elanto-dev/NewDevicesLab/README.md

This project was created as a part of the course New Devices Lab.
 
https://github.com/Naveen512/IonicAndVueJWTAuthentication was used as a template for the autentication of the front-end
