elanto-dev/NewDevicesLab/3D models/BIGBDFW_SmallerAndNormal-shelf-sensors.curaproject.3mf

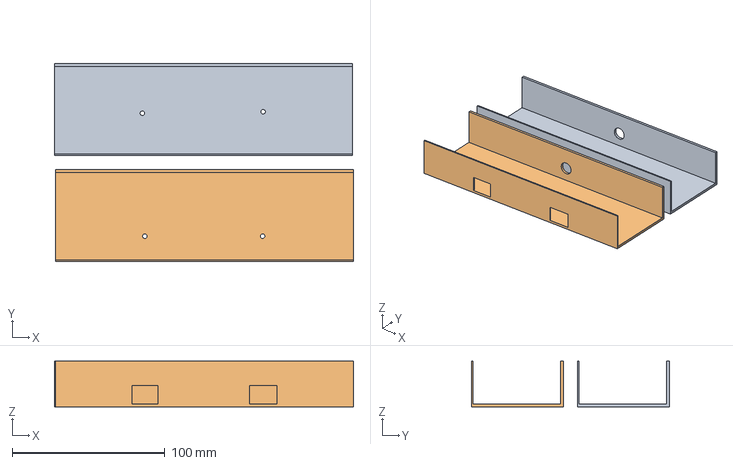
[picture p18: CAD file, 2022-10-01]
3D models/BIGBDFW_SmallerAndNormal-shelf-sensors.curaproject.3mf
195.6 x 129.4 x 30.0 mm
