elanto-dev/NewDevicesLab/3D models/Smaller-shelf-sensors.stl

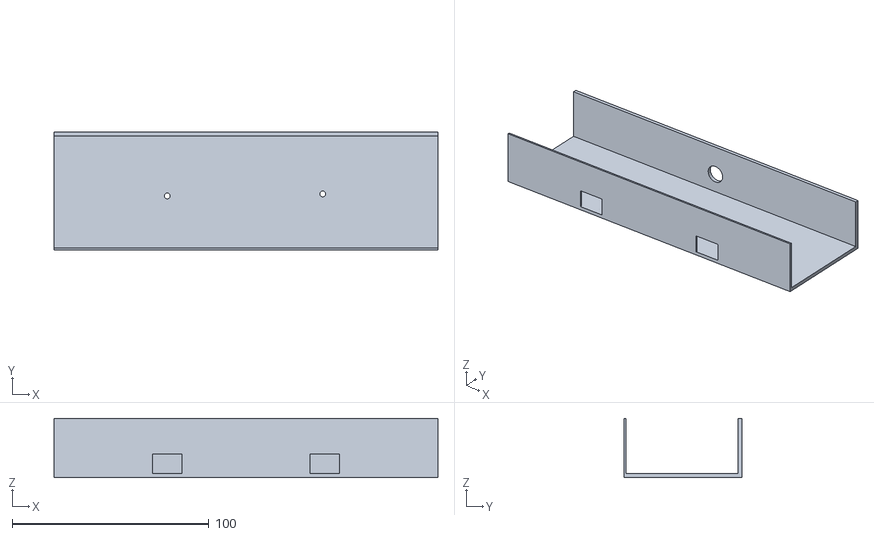
[picture p19: CAD file, 2022-10-01]
3D models/Smaller-shelf-sensors.stl
195.0 x 60.0 x 30.0
