elanto-dev/NewDevicesLab/3D models/Speaker_holder.stl

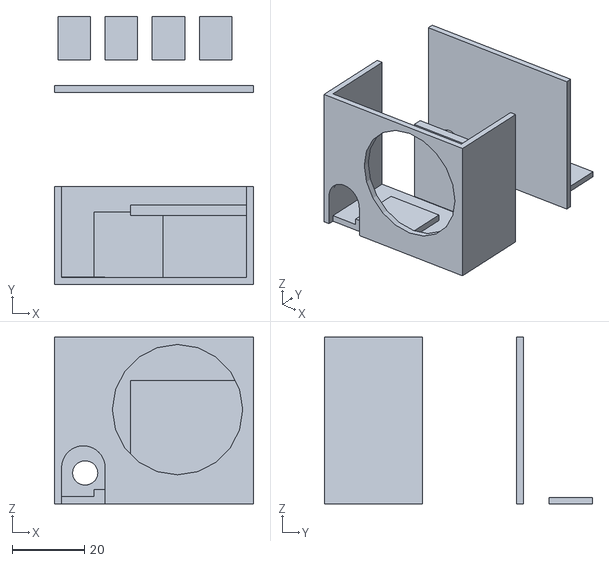
[picture p20: CAD file, 2022-10-01]
3D models/Speaker_holder.stl
55.0 x 74.0 x 46.0
