elanto-dev/NewDevicesLab/3D models/Shelf_screen_holders.curaproject.3mf

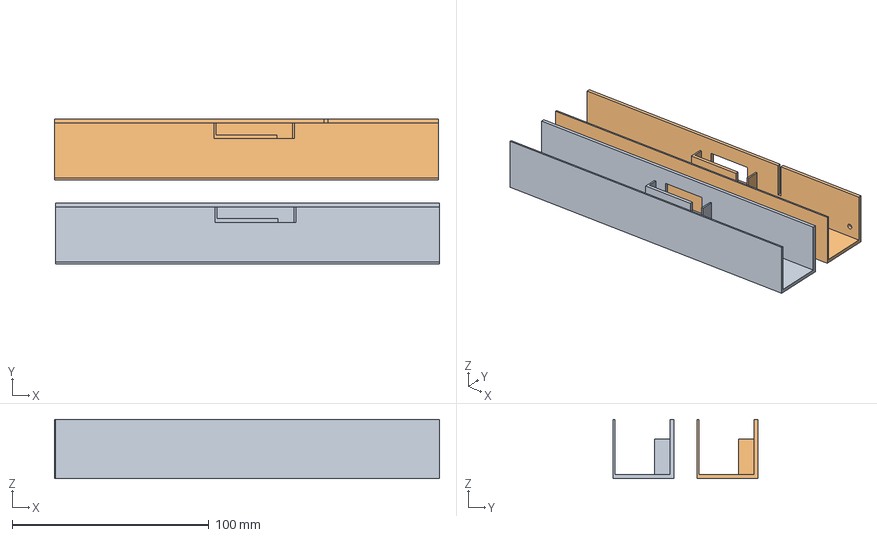
[picture p21: CAD file, 2022-10-01]
3D models/Shelf_screen_holders.curaproject.3mf
195.6 x 73.6 x 30.0 mm
