elanto-dev/NewDevicesLab/3D models/Hook.stl

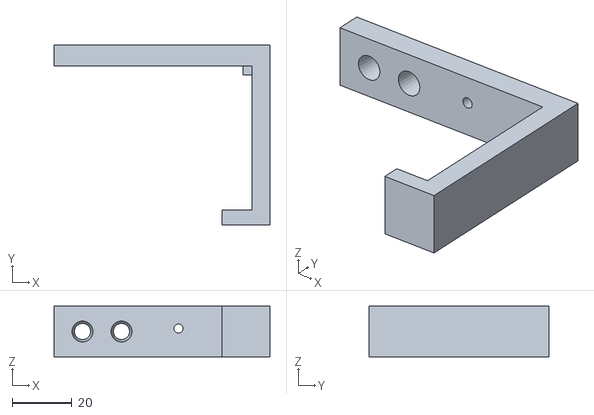
[picture p22: CAD file, 2022-10-01]
3D models/Hook.stl
72.0 x 60.0 x 17.0
