elanto-dev/NewDevicesLab/3D models/Shelf_screen_holder.stl

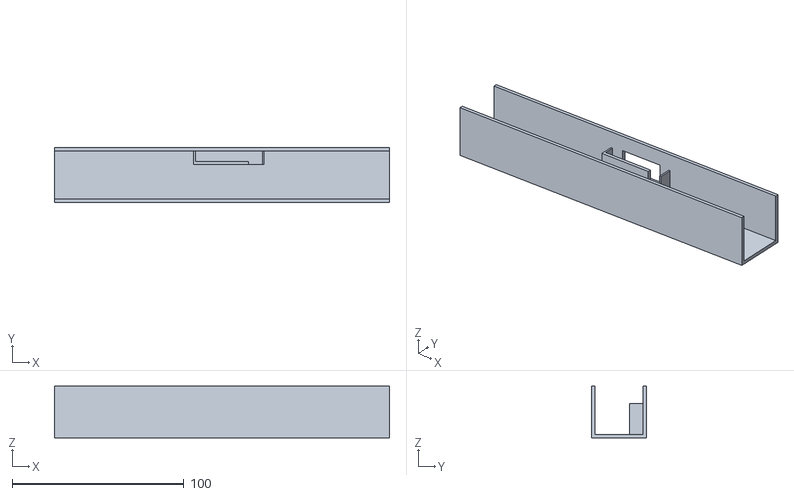
[picture p23: CAD file, 2022-10-01]
3D models/Shelf_screen_holder.stl
195.0 x 32.0 x 30.0
