elanto-dev/NewDevicesLab/3D models/Shelf_screen_holder_wNFC.stl

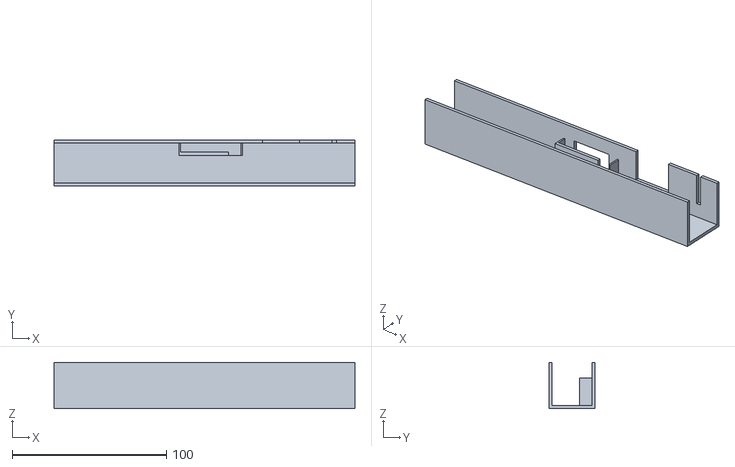
[picture p24: CAD file, 2022-10-01]
3D models/Shelf_screen_holder_wNFC.stl
195.0 x 30.0 x 30.0
