elanto-dev/NewDevicesLab/3D models/Screen_holder.curaproject.3mf

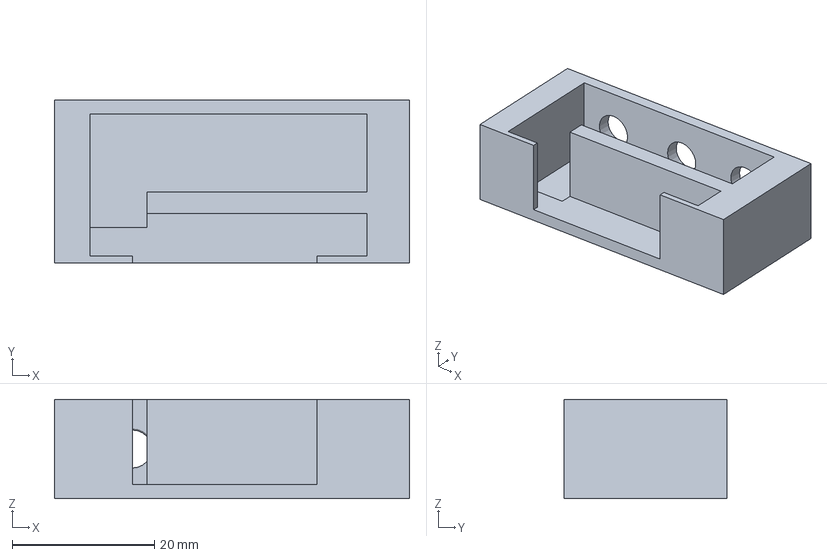
[picture p25: CAD file, 2022-10-01]
3D models/Screen_holder.curaproject.3mf
50.0 x 23.0 x 14.0 mm
