elanto-dev/NewDevicesLab/3D models/Shelf_screen_holders(1NFC-2Holders).3mf

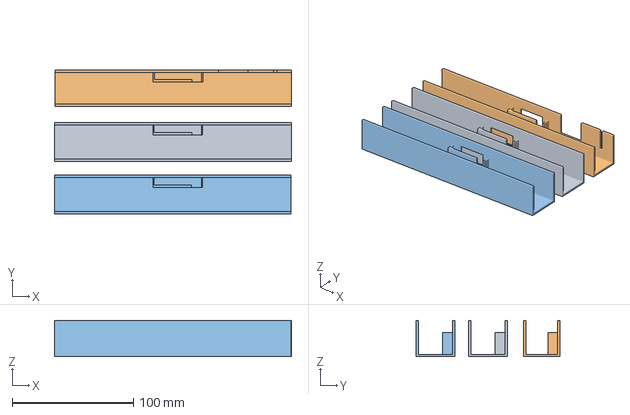
[picture p26: CAD file, 2022-10-01]
3D models/Shelf_screen_holders(1NFC-2Holders).3mf
195.3 x 118.7 x 30.0 mm
