elanto-dev/NewDevicesLab/(list of files, cad)

Other CAD files:
3D models/Shelf-sensors.stl
3D models/BIGBDFW_Shelf-sensors.curaproject.3mf
3D models/Screen_holder.stl
3D models/Hook.curaproject.3mf
