elanto-dev/NewDevicesLab/(list of files, drawings)

Other design files:
fritzing/extension_shelf.fzz
fritzing/main_shelf.fzz
