elanto-dev/NewDevicesLab/Arduino/AFinalCode/finalcode/icons.h

const uint8_t key_icon[] = {
   0x00, 0x00, 0x00, 0x00, 0x00, 0x00, 0x00, 0x00, 0x00, 0x00, 0x00, 0x00,
   0x00, 0x00, 0x00, 0x00, 0x00, 0x00, 0x00, 0x00, 0x00, 0x00, 0x00, 0x00,
   0x00, 0x00, 0x00, 0x00, 0x00, 0x00, 0x00, 0x00, 0x00, 0x00, 0x00, 0x00,
   0xf0, 0x07, 0x00, 0x00, 0xfc, 0x1f, 0x00, 0x00, 0xfc, 0x1f, 0x00, 0x00,
   0xfe, 0xff, 0xff, 0x1f, 0xff, 0xff, 0xff, 0x3f, 0xe7, 0xff, 0xff, 0x7f,
   0xc3, 0xff, 0xff, 0xff, 0xc3, 0xff, 0xff, 0x7f, 0xe7, 0xff, 0xff, 0x3f,
   0xff, 0xff, 0x23, 0x13, 0xfe, 0xff, 0x01, 0x00, 0xfc, 0x1f, 0x00, 0x00,
   0xfc, 0x1f, 0x00, 0x00, 0xf0, 0x07, 0x00, 0x00, 0x00, 0x00, 0x00, 0x00,
   0x00, 0x00, 0x00, 0x00, 0x00, 0x00, 0x00, 0x00, 0x00, 0x00, 0x00, 0x00,
   0x00, 0x00, 0x00, 0x00, 0x00, 0x00, 0x00, 0x00, 0x00, 0x00, 0x00, 0x00,
   0x00, 0x00, 0x00, 0x00, 0x00, 0x00, 0x00, 0x00 };
   
 const uint8_t bag_icon[] = {
   0x00, 0xf0, 0x0f, 0x00, 0x00, 0x18, 0x30, 0x00, 0x00, 0x04, 0x40, 0x00,
   0x00, 0xf2, 0x9f, 0x00, 0x00, 0x09, 0xa0, 0x00, 0x00, 0x09, 0xa0, 0x00,
   0x00, 0x09, 0xa0, 0x00, 0x7f, 0xf9, 0xbf, 0xff, 0x01, 0x01, 0xa0, 0x80,
   0x01, 0x01, 0x20, 0x80, 0xff, 0xff, 0xff, 0xff, 0x01, 0x00, 0x00, 0x80,
   0x01, 0x01, 0x20, 0x80, 0x01, 0x01, 0x20, 0x80, 0x01, 0x00, 0x00, 0x80,
   0x01, 0x00, 0x00, 0x80, 0x01, 0x00, 0x00, 0x80, 0x01, 0x00, 0x00, 0x80,
   0x01, 0x00, 0x00, 0x80, 0x01, 0x00, 0x00, 0x80, 0x01, 0x00, 0x00, 0x80,
   0x01, 0x00, 0x00, 0x80, 0x01, 0x00, 0x00, 0x80, 0x01, 0x00, 0x00, 0x80,
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
   0x00, 0x00, 0x01, 0x00, 0x00, 0x80, 0x00, 0x00, 0x00, 0x80, 0x09, 0x00,
   0x00, 0x80, 0x08, 0x00, 0x00, 0x80, 0x09, 0x00, 0x00, 0x00, 0x0f, 0x00,
   0x00, 0x00, 0x02, 0x00, 0x00, 0x00, 0x00, 0x00, 0x00, 0x00, 0x00, 0x00,
   0x00, 0x00, 0x00, 0x00, 0x00, 0x00, 0x00, 0x00 };
